heloizamartins/Sistema_Automatico_de_Irrigacao/Diagrama de Blocos.jpg

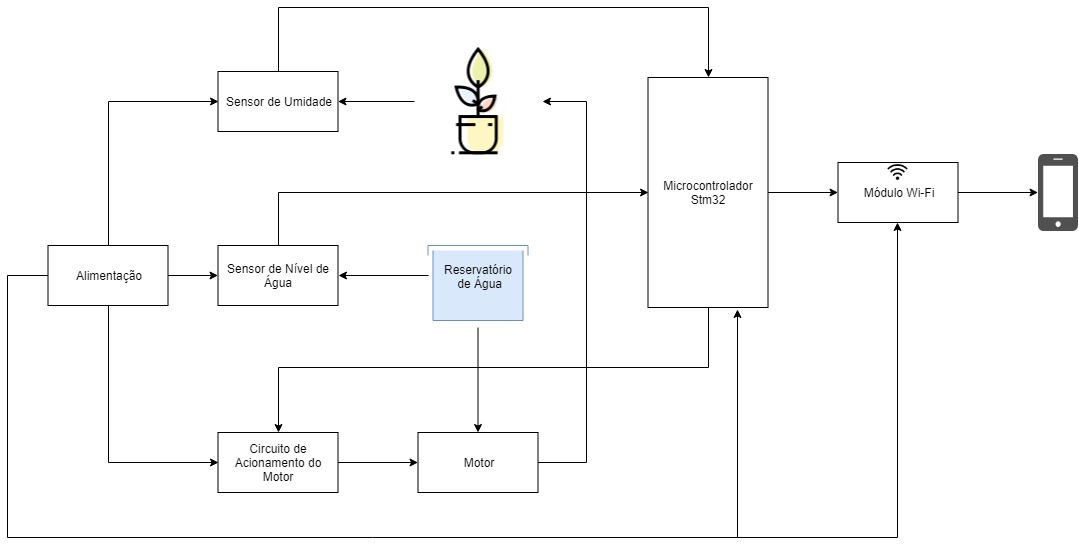
Diagrama de Blocos.jpg
