heloizamartins/Sistema_Automatico_de_Irrigacao/Figuras/alimentacao_9V-5V.jpg

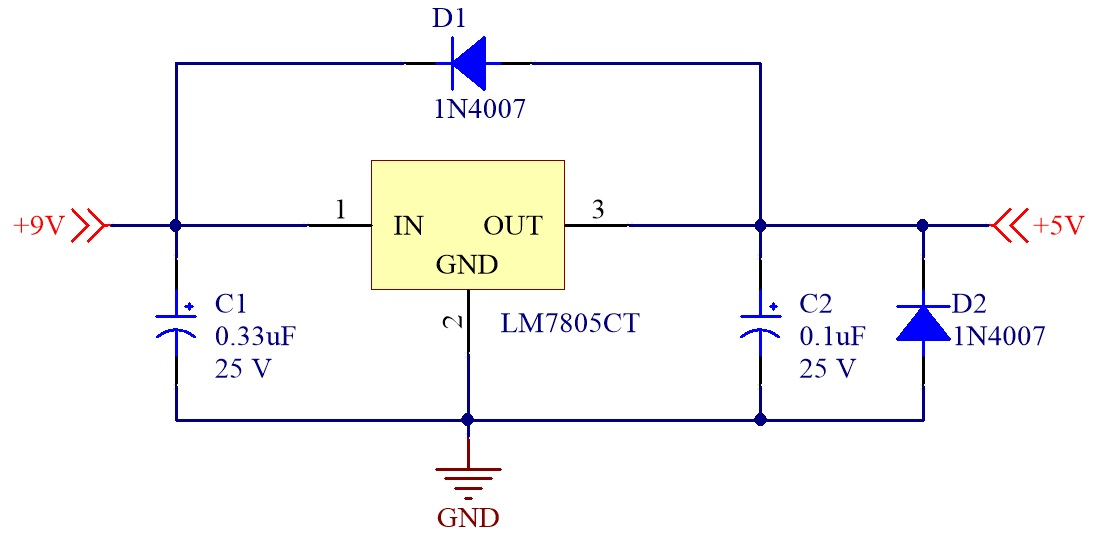
Figuras/alimentacao_9V-5V.jpg
