heloizamartins/Sistema_Automatico_de_Irrigacao/Figuras/placa_final_vista_sup.jpg

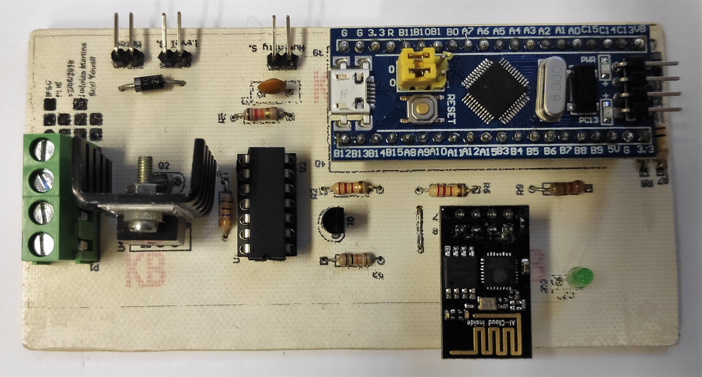
Figuras/placa_final_vista_sup.jpg
