heloizamartins/Sistema_Automatico_de_Irrigacao/Figuras/TEK0003.JPG

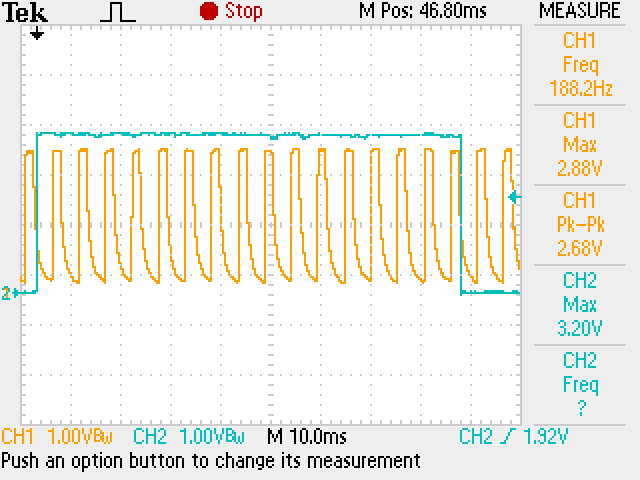
Figuras/TEK0003.JPG
