heloizamartins/Sistema_Automatico_de_Irrigacao/Cronograma.pdf

## Sistema Automotizado de Irrigação de Plantas

## Projeto

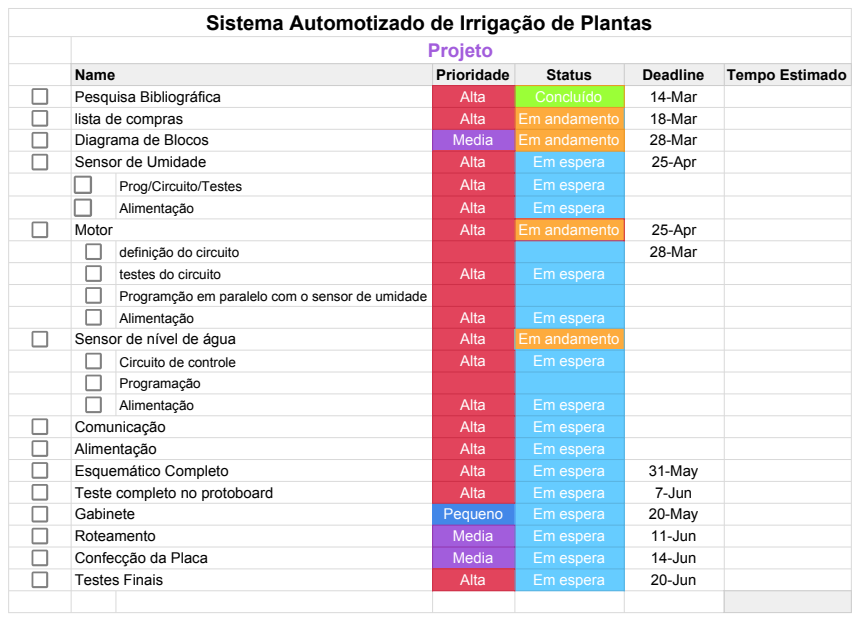
[picture p23: page 1]
Name; Prioridade; Status; Deadline; Tempo Estimado; Pesquisa Bibliográfica; Alta; Concluído; 14-Mar; lista de compras; Em andamento; 18-Mar; Diagrama de Blocos; Media; 28-Mar; Sensor de Umidade; Em espera; 25-Apr; Prog/Circuito/Testes; Alimentação; Motor; definição do circuito; testes do circuito; Sensor de nível de água; Circuito de controle; Programação; Comunicação; Esquemático Completo; 31-May; Teste completo no protoboard; 7-Jun; Gabinete; Pequeno; 20-May; Roteamento; 11-Jun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

Programção em paralelo com o sensor de umidade
