heloizamartins/Sistema_Automatico_de_Irrigacao/IrrigationSystem/Src/main.c

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

/* Includes ------------------------------------------------------------------*/
#include "main.h"

/* USER CODE BEGIN Includes */
#include <string.h>
#include <stdio.h>
#include "modbus.h"
#include "IrrigationSystem.h"
/* USER CODE END Includes */

/* USER CODE BEGIN PTD */
//char txDmaBuffer[100];

/* USER CODE END PTD */

ADC_HandleTypeDef hadc1;
DMA_HandleTypeDef hdma_adc1;

TIM_HandleTypeDef htim1;
TIM_HandleTypeDef htim2;

UART_HandleTypeDef huart1;
DMA_HandleTypeDef hdma_usart1_rx;
DMA_HandleTypeDef hdma_usart1_tx;

void SystemClock_Config(void);
static void MX_GPIO_Init(void);
static void MX_DMA_Init(void);
static void MX_ADC1_Init(void);
static void MX_USART1_UART_Init(void);
static void MX_TIM1_Init(void);
static void MX_TIM2_Init(void);
/**
  * @brief  The application entry point.
  * @retval int
  */
int main(void)
{
  /* USER CODE BEGIN 1 */
  package_t pkg;
  IrrigationSystem_t IS;
  /* USER CODE END 1 */
  

  /* MCU Configuration--------------------------------------------------------*/

  /* Reset of all peripherals, Initializes the Flash interface and the Systick. */
  HAL_Init();

  /* Configure the system clock */
  SystemClock_Config();

  /* Initialize all configured peripherals */
  MX_GPIO_Init();
  MX_DMA_Init();
  MX_ADC1_Init();
  MX_USART1_UART_Init();
  MX_TIM1_Init();
  MX_TIM2_Init();
  /* USER CODE BEGIN 2 */

  IrrigationSystem_init();
  Turn_Off_Motor();
  volatile uint16_t min_humidity = 0;
  /* USER CODE END 2 */

  /* Infinite loop */
  /* USER CODE BEGIN WHILE */
  while (1)
    {
	  min_humidity = RTU_Read_package_IrrigationSystem(&pkg, &huart1, &IS);
	  if(min_humidity < 10){
		  min_humidity = 10;
	  }
	  RTU_package_IrrigationSystem(&pkg, &IS, &huart1);
	  Verify_Humidity(&IS, min_humidity);
	  RTU_package_IrrigationSystem(&pkg, &IS, &huart1);
	  HAL_Delay(2000);
    /* USER CODE END WHILE */

    /* USER CODE BEGIN 3 */
    }
  /* USER CODE END 3 */
}

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
/* USER CODE BEGIN 4 */
void HAL_TIM_PeriodElapsedCallback(TIM_HandleTypeDef *htim)
{

}

/* USER CODE END 4 */
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
