heloizamartins/Sistema_Automatico_de_Irrigacao/IrrigationSystem/ADC_DMA_Timer.ioc

Mcu.UserName=STM32F103C8Tx
PA0-WKUP.Signal=ADCx_IN0
PA1.Signal=ADCx_IN1
PA10.Signal=USART1_RX
PA13.Signal=SYS_JTMS-SWDIO
PA14.Signal=SYS_JTCK-SWCLK
PA3.GPIO_Label=DEBUG_ADC_CC
PA3.Signal=GPIO_Output
PA8.Signal=S_TIM1_CH1
PA9.Signal=USART1_TX
PB10.Signal=S_TIM2_CH3
PB11.Signal=S_TIM2_CH4
PB3.Signal=S_TIM2_CH2
PB8.GPIO_Label=LED_MOTOR
PB8.Signal=GPIO_Output
PD0-OSC_IN.Signal=RCC_OSC_IN
PD1-OSC_OUT.Signal=RCC_OSC_OUT
