heloizamartins/Sistema_Automatico_de_Irrigacao/(commit log)

2019-03-19 Added Diagrama de Blocos.drawio
2019-03-19 Update Diagrama de Blocos.drawio
2019-03-19 Added Diagrama de Blocos.jpg
2019-06-06 pwm update
2019-06-13 level sensor
2019-06-13 Update level sensor
2019-06-17 change DMA buffer size
2019-06-18 Create RC CIRCUIT CAPACITOR.png
2019-06-18 Update RC CIRCUIT CAPACITOR.png
2019-06-28 capacitor figure
