heloizamartins/Sistema_Automatico_de_Irrigacao/(notices)

Notices in the files:
IrrigationSystem/Src/main.c:
COPYRIGHT(c) 2019 STMicroelectronics
(C) COPYRIGHT STMicroelectronics *****END OF FILE
